Alm1973/glucose-ring/IOS_APP_REPORT.md

# iOS relay — report

**Status (2026-09-23): the app is built, signed and installed on an iPhone 18
Pro (iOS 27.0); the ring firmware is flashed and the motor buzzes.**
Everything is on branch `ios-relay`, pushed to the private GitHub remote.
Section 14 is the current state — the table below is the September 12 snapshot.

| Phase | Result | Commit |
|---|---|---|
| 0 Audit | Reported, stopped for approval | (this file, first version) |
| 1 Remove Android | 22 files `git rm`'d; SDK, `~/.gradle`, `~/.android` removed; **2.14 GiB reclaimed** | `7cd58df` |
| 2 Firmware: ring pokes | protocol 3, MISS alarm, trusted clock; **450/0 host tests** | `64731af` |
| 3 iOS app | Swift core **112/0**, wire cross-check **27,888/27,888**, whole app typechecks (Catalyst); built, signed and installed on an iPhone 11 (§9–10) and an iPhone 18 Pro (§14) | this commit |

~~**Nothing has run on the ring or on a phone.**~~ Superseded: Xcode 27.0 is
installed, the app runs on a phone, and as of 2026-09-23 the firmware runs on
the ring and drives the motor. **No BLE link between the two has been tested.**

---

## 1. Done — and how each was verified

### Phase 0 — audit
- **Disk (measured):** Android SDK 524M, `~/.gradle` 1.4G, `~/.android` 3.5M,
  repo `android/` 26M (24M of it build output), `~/Library/Android` absent.
- **Reuse audit:** file by file. Design that survived: the staleness,
  future-date and validity rules; strict parsing; dedupe; token-safe errors;
  "Relaying only when the ring confirms"; the MTU chunking rule. The platform
  code is gone.
- **Safety net:** `nightscout-relay` held all 22 app files, and the tree was
  clean. `main` had never been merged: it still held the xDrip+ app.
- **Toolchain:** no Xcode. Command Line Tools 14.3.1 (Swift 5.8.1), with no
  iOS SDK and no XCTest.
- **Your decisions:** fast-forward `main`, then branch; remove the SDK,
  `~/.gradle` and `~/.android` only; poke with `#REQ` on the existing TX
  characteristic; sign with a free Personal Team.

### Phase 1 — Android removed (`7cd58df`)
- `main` was fast-forwarded to `686093e`, so it now holds the Nightscout app
  in history. `ios-relay` was cut from it, and `git rm -r android/` removed
  22 files.
- **Restore command** (22 files, verified recoverable):
  ```bash
  cd ~/projects/glucose-ring && git restore --source=nightscout-relay -- android/
  ```
- **Uninstalled:**
  - `brew uninstall --cask android-commandlinetools`. It left 351 MiB of
    `sdkmanager`-installed packages in the SDK folder, which I also removed.
  - `~/.gradle` and `~/.android`.
  - I first stopped the Gradle daemon that was still running from earlier
    builds.
  - Verified: all paths gone; `sdkmanager`, `avdmanager` and `adb` no longer
    on PATH.
- **Disk reclaimed, measured:** `df` free space went from 10,143,392 KiB
  (9.67 GiB) to 12,388,532 KiB (11.81 GiB). That's **+2.14 GiB**. `du` of what
  I removed sums to 2,015,608 KiB (1.92 GiB). The extra ~224 MiB is **not
  explained**; possibly Homebrew purging its download cache ("Purging files"
  in its output), possibly unrelated disk activity. I didn't attribute it.
- **Left in place, per your call:**
  - under `android/` (gitignored): `local.properties` (**contains your live
    token**), `app/build` 24M, `.gradle` 1.2M, `build` 132K, `.kotlin`;
  - Homebrew `gradle` and `openjdk` (605M);
  - the JDKs.

  `.gitignore` keeps its `android/` lines deliberately, so that token file can
  never be committed by accident.
- `PHONE_APP.md` now describes the iOS design, with the requirements carried
  over. `PHONE_APP_REPORT.md` is kept as the Android record, with a "retired"
  banner.

### Phase 2 — the ring drives the cycle (`64731af`)
- **Poke:** every ~5 min the ring sends `#REQ` on the **existing NUS TX
  characteristic**, so there is no new UUID. It sends at once on every fresh
  trusted link too. It only sends when the link is trusted and the phone has
  subscribed (`bleuart.notifyEnabled()`).
- **Miss counting** (`liveness.cpp`, pure):
  - A poke not answered by a valid `!TIME` within 30 s is a miss.
  - A poke that falls due with **no usable link** is a miss at once, so an
    out-of-range phone is caught too.
  - After `LV_MISS_ALERT_COUNT` = 3 in a row (a named constant), the ring is
    blind and buzzes **MISS**: 2 × 1000 ms at full drive. The pattern is fixed
    and refused as a low/high/stale pattern.
  - Priority: a current low/high, then MISS, then STALE, then none. **A blind
    ring is never silent.**
- **Trusted time:** the new `!TIME <epoch_ms>` gives the ring wall time.
  Readings are judged by **their own timestamp** against it, never by when
  they arrived.
  - No `!TIME` since boot means no reading is accepted.
  - More than 15 min old, or more than 2 min in the future, means dropped.
  - This fixes the protocol-2 flaw where a stale first reading after a reboot
    looked fresh.
- **Alignment:** the next poke is aimed at `reading + 5 min + 2 min`, clamped
  to between 1 and 5 minutes from now, so it can never be rarer than the
  fixed cadence.
- `PROTOCOL.md` was updated in the same commit (protocol 3, new §9), along
  with the README (MISS alarm, bring-up checklist steps 18–22). fw 3.0.0,
  proto 3; the config schema is unchanged; `#STATUS` is unchanged.
- **Verified:**
  - **Host tests: 450 passed, 0 failed** (from 343; no existing assertion
    changed). They include:
    - exhaustive checks that the ring is **never silent once blind** and
      **never acts on data that isn't current**;
    - simulated time-to-MISS at 1 s loop resolution: within 15.5 min whether
      the phone is connected-but-silent or out of range;
    - the pinned default of 3 × 5 min.
  - **Mutation test:** six deliberate breaks of the safety logic, each
    **caught**, plus a positive control that passes. The breaks were: drop
    "blind → MISS"; low/high on stale data; link-down poke not counted;
    no-clock treated as fresh; miss count raised to 4; `!TIME` floor removed.
  - **Firmware compiles** in both the default and the
    `TEST_MODE`/`DEBUG_SERIAL` builds: 137,292 bytes flash (16%), 14,660 bytes
    RAM. The **only warning in the whole build**, core included, is the
    existing placeholder-threshold `#warning`.

### Phase 3 — iOS app (this commit)
- **`ios/Core`** (pure, Foundation only):
  - `RingProtocol`: wire format, direction hygiene, `!TIME`, ring-line
    parsing, reassembly, chunking.
  - `Nightscout`: strict parsing. Whole numbers only; ms epoch; booleans and
    strings refused.
  - `Relay`/`RelayState`: only current, valid readings are written; dedupe
    per link; a **sticky "token rejected"** that a network blip cannot clear;
    honest status; `Backoff`.
- **`ios/GlucoseRing`** (the app):
  - `CBCentralManager` with `CBCentralManagerOptionRestoreIdentifierKey`.
    `centralManager(_:willRestoreState:)` **reattaches to the restored
    peripheral and never rescans**. The central is created in
    `didFinishLaunching` via `UIApplicationDelegateAdaptor`, so it exists on a
    background relaunch.
  - Info.plist sets `UIBackgroundModes = bluetooth-central` and
    `NSBluetoothAlwaysUsageDescription`.
  - **On `#REQ`:**
    1. `!TIME` is written first;
    2. then one GET (5 s timeout, no retry);
    3. then the reading is written back;
    4. then `!GET STATUS` confirms it.

    It runs inside `beginBackgroundTask`.
  - **401/403 is shown as "Token rejected"**, distinct from "Can't reach
    Nightscout", plus one local notification. It stays until a fetch
    succeeds.
  - **Reconnect:** an immediate, non-expiring `connect()`. Only
    connect-then-drop loops are paced, and never by more than 8 s, inside a
    background task.
  - Writes are chunked to MTU − 3. The ring's RX characteristic is sized to
    MTU 23 (`BLEUart.cpp:179`; `BANDWIDTH_LOW` = default MTU,
    `bluefruit.cpp:232`), so a long write would be rejected.
- **Secrets:** `ios/GlucoseRing/Secrets.plist`. `git check-ignore` confirmed
  it was ignored (`.gitignore:28`) **before** it was written. It holds the
  placeholder, and git does not list it.
- **`tests/run_wire_crosscheck.sh` is re-enabled.** It is now fed by the Swift
  exporter and needs only Command Line Tools.
- **Verified:**
  - **Swift core tests: 112 passed, 0 failed**, built with
    `-warnings-as-errors`. They include the live Nightscout body as a fixture,
    every truncation of it, and an exhaustive 180-combination check that
    "Relaying" appears for exactly one combination.
  - **Mutation test:** six deliberate breaks, each **caught**, plus a positive
    control. The breaks were: stale readings sent; future-dated sent; a
    network blip clearing 401; "Relaying" without the ring's confirmation;
    `"204"` coerced; commas kept.
  - **Wire cross-check:** the Swift formatter's 27,888 lines (829,314 bytes),
    fed in 20-byte chunks through the firmware's real `rp_parse()`, **all
    decode exactly**.
  - **Whole app typechecks** against the Mac Catalyst SDK
    (`arm64-apple-ios16.0-macabi`, Command Line Tools' macOS 13.3 SDK).
    That covers CoreBluetooth, restoration, UIKit, SwiftUI and
    UserNotifications, with no errors or warnings. **This is not an iOS
    build.**
  - `Info.plist` and `project.pbxproj` pass `plutil -lint`. The project
    parses to 17 objects with no dangling references.
  - The firmware host suite is still 450/0.

## 2. Not done

| Item | Blocked on |
|---|---|
| Build for iOS, open the Xcode project, install on the iPhone | **Xcode is not installed.** You must install it: it needs your Apple ID sign-in, license acceptance and `sudo xcode-select`. **Disk: 11.81 GiB free. Plan for roughly 20–25 GB** (estimate, not measured). Build steps: PHONE_APP.md §5. |
| Real token in the app | You, pasting into `ios/GlucoseRing/Secrets.plist` |
| Anything on the ring | Hardware. You didn't say whether it has arrived. |
| **Measure** the added sleep current | Hardware + µA meter (README checklist step 11). Section 6 is a calculation. |
| Deployment target | **Resolved:** iPhone 11 on iOS 26.6.2; set to iOS 26.0 (session (b), §7). |
| Tuning `LV_ALIGN_LAG_MS` (2 min) | Real arrival-lag data; there's only one sample |
| The app following a changed ring stale window (`!SET STALE`) | Not built. The app uses 15 min for its own checks; the ring is authoritative. |
| Deleting `android/` leftovers, including `local.properties` with your live token | Your call. I recommend deleting it once the token is in `Secrets.plist`. |
| Merging `ios-relay` into `main` / a remote backup | Your call. **This `.git` directory is the only copy of the history.** |

## 3. Assumptions — inferred, not read

1. **iOS pairs when the ring sends its Security Request.** iOS has no app API
   to start bonding, and the NUS characteristics are open, so nothing else
   triggers pairing. The ring ignores unencrypted links. **If iOS does not
   honour the request, the app never gets data.** This was the top risk.
   **RESOLVED 2026-09-23 (§15): iOS raised its pairing dialog on the first
   connect, the bond completed, and it survived a firmware reflash — the
   phone reconnects with no prompt.**
2. iOS wakes the suspended app for a notification with roughly 10 s of
   execution; `beginBackgroundTask` extends that a little. From memory of
   Apple's documentation; not measured.
3. State restoration relaunches the app after a **system** kill; **not after
   a force-quit**, and not after a reboot until the app is opened. The ring's
   MISS alarm is the backstop.
4. With the SwiftUI lifecycle, `UIApplicationDelegateAdaptor`'s
   `didFinishLaunching` runs on a background relaunch, so the central is
   created in time.
5. A free Personal Team allows the `bluetooth-central` background mode. Its
   **7-day expiry** means reinstalling weekly; when you forget, the ring
   buzzes MISS.
6. The bundle ID `com.glucosering.relay` is free for your team. It may need
   changing.
7. `maximumWriteValueLength(for: .withoutResponse)` reports MTU − 3 (20 here),
   while `.withResponse` would report 512.
8. The project uses the `objectVersion 77` synchronized-folder format as I
   remember it from Xcode 16. It is linted, but never opened.
9. A clean Catalyst typecheck implies a clean iOS compile. Availability can
   differ between the two (for example restoration symbols); not proven.
10. iOS Foundation's JSONSerialization tells integers, decimals and booleans
    apart the same way macOS 26's does (the tests ran on macOS).
11. `LV_ALIGN_LAG_MS` = 2 min is a guess; the only data point is one reading
    fetched 2.4 min after it was taken.
12. MISS shares the stale repeat cap (6 buzzes, about 30 min, then the
    "gave up" pattern), extending your earlier cap decision to it.
    `!SET STALEREPEATS 0` disables the cap for both.
13. MISS (2 × 1000 ms) can be told apart from low (3 × 400 ms) on a finger.
    Ergonomics. **RESOLVED 2026-09-23 (§14): tested on the assembled ring —
    all six patterns felt distinct, MISS included.**
14. All battery figures in section 6 are calculated, not measured.

## 4. Discrepancies

1. **"315 assertions."** Actually 343 at the start; now 450.
2. **`main` had never been merged** and held the xDrip+ app. Resolved by your
   fast-forward decision.
3. **"Add a request characteristic" vs "do not invent UUIDs."** A new
   characteristic needs a new UUID. Resolved by your choice: `#REQ` on the
   existing TX notify characteristic.
4. **"Keep the existing reading characteristic."** There is no separate one:
   readings and commands share NUS RX, which is the write-back channel.
5. **"RTC wake… the budget assumed the ring was passive."** The ring was
   never asleep between readings. `loop()` already wakes every 1 s and holds
   a live connection. The poke is a timer check in that loop, with no new
   wake source.
6. **"Measure the added sleep current."** Impossible without hardware;
   calculated instead (section 6).
7. **"Use timestamps, don't trust arrival time."** The ring has no clock, so
   this needed `!TIME`. That is a **breaking** protocol change: readings
   without a prior `!TIME` are now dropped, and the bring-up checklist was
   updated to match. Any protocol-2 client, such as the retired Android app,
   no longer works.
8. **"Reconnect with backoff."** On iOS the idiom is an immediate,
   non-expiring `connect()`; an app timer can't run while suspended. Backoff
   is used only for connect-then-drop loops, capped at 8 s so it can't strand
   the app.
9. **"If the fetch fails, let the ring's miss counter do its job."** The app
   sends `!TIME` **before** it fetches, so a failed fetch shows on the ring as
   **STALE**, and **MISS** means the phone, app or link itself is gone. The
   ring would otherwise make a revoked token and a dead phone buzz
   identically. This is deliberate and reversible on the app side; say if you
   want a failed fetch to count as a miss.
10. **"Reuse the schematic and BOM."** Neither exists in the repo; only README
    §2 (ASCII wiring and a pin table).
11. `#ALERT miss sgv=65` carries the **last known** sgv, inherited from the
    existing `#ALERT` format. It is not a current value.
12. The cross-check was deliberately disabled (exit 2, "DISABLED") between
    `7cd58df` and this commit.
13. Docs vs firmware: `PROTOCOL.md` and the firmware were changed together,
    and no disagreement remains that I know of. The firmware stays
    authoritative.

## 5. Untested — written, never exercised

- **Firmware protocol 3 on hardware:**
  - whether `#REQ` reaches the phone;
  - `notifyEnabled()` gating;
  - `!TIME` handling;
  - the MISS buzz itself;
  - the clamp on alignment;
  - the added current.
- **The entire iOS app on a device:**
  - pairing;
  - state restoration and background relaunch;
  - the wake window;
  - `URLSession` against the live server (only `curl` has been tried);
  - chunked writes on a real stack;
  - `!GET STATUS` confirmation;
  - the UI;
  - the local notification;
  - reconnect pacing;
  - the 7-day expiry.
- **`GlucoseRing.xcodeproj`:** never opened or built.

## 6. Battery impact — calculated, not measured

**Old design:** a passive ring holding a live connection (200–400 ms
interval, slave latency 4) with a 1 s loop tick. README §11 estimates 50–150
µA idle; that is itself unmeasured.

**What the new cycle adds, every ~5 min.** At the ring's MTU of 23, a cycle
with a new reading is about 9 small packets:

| Direction | Packets |
|---|---|
| Ring → phone | `#REQ` 1, `#OK TIME` 1, `#STATUS` reply 3 |
| Phone → ring | `!TIME` 1, reading 2, `!GET STATUS` 1 |

That is roughly **5–9 extra connection events** the ring would otherwise skip
under slave latency. A cycle without a new reading is about 2–3 events.

**Cost:**

- At an assumed 5–10 µC per event (nRF52840 radio ≈ 5 mA at 0 dBm for
  1–2 ms, plus a CPU wake), that's 25–90 µC per 300 s, so **≈ 0.1–0.3 µA
  average**.
- Relative to the 50–150 µA baseline, that's **≤ 0.6 %**.
- On the 40 mAh cell at 100 µA, runtime goes from ≈ 400 h to ≈ 399 h.

**No new wake source** is needed: the timer check runs in the existing 1 s
loop.

**Alarms cost more than polling:** one MISS buzz is ≈ 85 mA × 2 s ≈ 0.17 C.
A full capped MISS episode (6 buzzes plus give-up) is ≈ 1 C, about 0.7 % of
the cell. This happens only when something is already wrong.

**Phone side:** about 288 background wakes a day, each with one HTTPS GET.
Unmeasured.

**To measure:** README checklist step 11 (µA meter inline), with pokes
answered, and with the phone away.

## Corrections — things I got wrong mid-task

- **Battery estimate.** Phase 0 said 2–4 extra events and +0.03–0.13 µA. I
  had not counted the `#OK TIME` reply, the `!GET STATUS` confirmation, or
  `#STATUS` spanning 3 notifications at MTU 23. Revised to 5–9 events and
  +0.1–0.3 µA; the README is corrected in this commit.
- **The firmware warning check.** My first grep could never match
  `glucose-ring.ino` (its pattern demanded a second file extension), so "no
  warnings" was unproven for the sketch. Rechecked with a working filter: the
  only warning is the intentional placeholder one.
- **A compile run showed "Exit code 1"** although both compiles returned 0.
  That was my shell's final `[ … ] && …` test, not a failure. Noted so the
  log isn't misread.
- **Reclaimed space.** In Phase 0 I estimated about 1.95 GB. It was 2.14 GiB
  by `df` and 1.92 GiB by `du`, and I did not explain the gap.

---

## Session 2026-09-12 (b): backup, disk, cleanup before Xcode

**Status: DONE.** The repo is backed up to GitHub and the cleanup is done.
Sections 1–5 are the read-only analysis as presented to you; the measured
results after your go-ahead are in section 6.

### 1. Backup — blocked on a GitHub credential

**Repo:** `github.com/Alm1973/glucose-ring`. It is **not public**: GitHub's
unauthenticated API returns 404, where a public repo returns 200. I can't
check whether it is empty until I can authenticate.

**Safe to push:**
- The 9 commits reachable from any ref never contained a file named
  `Secrets.plist` or `local.properties`, on any branch, at any point in
  history.
- The live token's *value* appears in **0** locations across every commit.
  It was searched without being printed.
- Both files are still ignored (`.gitignore:22`, `.gitignore:28`).

**Local repo:** clean; branches `main` and `nightscout-relay` at `686093e`,
`ios-relay` at `7aa9927`; no tags, no stash; `.git` is 1.0 MB.

**Why I can't push yet:**
- `gh` is not installed.
- There is no HTTPS credential helper and no Keychain entry.
- `~/.ssh/id_ed25519` exists, but **GitHub lists 0 keys for Alm1973**, and
  SSH is refused. The key is also passphrase-protected and not loaded in
  `ssh-agent`.
- GitHub's host key was verified against the fingerprint GitHub publishes
  over TLS (`SHA256:+DiY3wvvV6TuJJhbpZisF/zLDA0zPMSvHdkr4UvCOqU`). It is held
  in a scratch file only; `~/.ssh` is untouched.

**Planned once you've added the key and approved:**
1. Add the verified GitHub host key to `~/.ssh/known_hosts`.
2. `git remote add origin git@github.com:Alm1973/glucose-ring.git`.
3. `git ls-remote origin`. Stop if the repo is not empty.
4. `git push origin main nightscout-relay ios-relay`.
5. Verify with `git ls-remote --heads origin`: all three branches, with SHAs
   matching the local ones.

### 2. Disk — measured, nothing deleted

**Totals:** APFS container 245.1 GB; **free 12.1 GB** (`df`: 11 GiB avail);
Data volume 192 GiB used.

**Safe to delete** (regenerable caches; quit the app first). Subtotal
**≈ 12 GB**.

| Path | Size | What breaks |
|---|---|---|
| `~/Library/Caches` (all) | 9.3 GB | Apps rebuild their caches; slower first launch. Inside: Google 2.6G, Spotify 1.7G, Brave 1.5G, Google SoftwareUpdate 0.67G, Homebrew 0.65G, JetBrains 0.47G (IntelliJ is no longer installed), ms-playwright 0.45G (re-downloads its browsers), WhatsApp 0.43G, Zoo updater 0.3G, pip 0.13G |
| `~/Library/Application Support/discord/Cache` | 756 MB | Discord re-downloads media |
| `~/.cache/huggingface` | 680 MB | Models re-download on next use |
| `~/Library/Application Support/Spotify/PersistentCache` | 625 MB | Streaming cache re-buffers |
| Claude `Cache` + `Code Cache` | 451 MB | App caches rebuild |
| `~/Library/Logs` | 201 MB | Old logs only |
| `brew cleanup` | ~229 MB | Old Homebrew versions; overlaps the Homebrew cache above |
| `~/.npm` | 25 MB | npm cache |

**Ask first** (not caches, or not regenerable), ranked by size:

| Path | Size | What breaks |
|---|---|---|
| `~/.ollama/models` | 11 GB | 4 local models (llava 4.7, qwen2.5vl 3.2, llama3.2 2.0, moondream 1.7 GB); gone until `ollama pull` again |
| `~/Library/Application Support/Claude/vm_bundles` | 9.8 GB | Claude desktop's VM image for its sandboxed features. The app re-downloads it. **This session runs inside that app**: quit it first. |
| `/Users/Shared/Epic Games/Fortnite` | 9.4 GB | Fortnite install. The Epic Games Launcher isn't installed, so it's likely orphaned. Re-download is about the same size. |
| `~/Downloads`: 98 videos | 7.3 GB | Your own videos (`IMG_*.MOV`), gone unless kept elsewhere |
| `~/Downloads`: 77 installers & archives | 5.9 GB | `.dmg`/`.pkg`/`.zip`; installed apps are unaffected |
| `/Applications/iMovie.app` | 2.5 GB | Reinstallable from the App Store |
| Chrome profiles 4, 3, 8 | 3.2 GB | Browsing data; clear the cache from inside Chrome instead |
| `~/Downloads`: images | 1.7 GB | Personal |
| Google `DriveFS` | 1.2 GB | Google Drive's local cache; **may hold unsynced files** |
| `/Applications/ParaView-5.13.3.app` | 1.2 GB | Reinstallable |
| `~/Movies` | 1.1 GB | Personal |
| `~/Downloads/jdk-21.0.4.jdk` (×3) + `jdk-21_macos-aarch64_bin.tar.gz` | 1.1 GB | Copies of the JDK already installed in `/Library/Java`. *Assumed* unused. |
| Google `GoogleUpdater` | 759 MB | Chrome's updater rebuilds it |
| `~/.p2` | 656 MB | Eclipse bundle pool. No `Eclipse.app` was found, so it's *likely* leftover. |
| `~/Library/Roblox` | 576 MB | Roblox data |
| `~/mlx_env`, `~/robotenv`, `~/tf_env` | 0.49 / 0.20 / 0.01 GB | Python venvs; projects using them break until recreated |

**Keep:**
- `~/Library/Arduino15` (1.6 GB): the firmware build needs the Seeeduino core.
- `/Library/Developer/CommandLineTools` (2.6 GB): Homebrew, `arduino-cli`,
  `clang` and `swiftc` use it, at least until Xcode is installed.

**Could not measure.** About 90 GB of the used space is hidden from this
shell by macOS privacy protection:
- `~/.Trash`, Mail, Messages, Safari, and iOS device backups (MobileSync);
- `~/Pictures`, which reads 0 B here and is probably hidden too;
- the two other accounts, `s_khidake` and `sakshiskhidake`;
- system data.

**System Settings → General → Storage** sees all of it. Check the Trash and
iOS backups there first; they are often the biggest easy wins.

**Getting to ~30 GB:** safe caches (≈ 12) + Ollama (11) + the Claude VM (9.8)
≈ 33 GB. Alternatively, Fortnite (9.4) + Downloads installers and the JDK
copies (7.0) + caches (12) ≈ 28 GB.

### 3. Android leftovers — checked, deletion pending

**Measured, ready to delete:** `android/` is 26,268 KiB (696 files, 0
tracked):

| Path | KiB |
|---|---|
| `local.properties` | 4 |
| `app/build` | 24,940 |
| `.gradle` | 1,192 |
| `build` | 132 |
| `.kotlin` | 0 |

**`local.properties` still holds the only local copy of your token.**
`Secrets.plist` still has the placeholder, so deleting it now would lose the
token.

**Homebrew `gradle` 9.7.1 (225M) and `openjdk` 26.0.2.1 (380M):**
- `brew uses --installed`: nothing depends on `gradle`; `openjdk` is used
  only by `gradle`.
- No other Gradle or Maven project exists under `~`.
- No shell config refers to them.
- They are not linked into `/Library/Java`.

**Safe to remove.**

**JDKs: leaving them.** I can't show that nothing needs them.
- `jdk-21` (Oracle package, installed 2024-08-06) and `openjdk-22.0.2`
  (downloaded by IntelliJ, 2024-08-02; it is the default `java`).
- The OpenFOAM (SimFlow) app bundles no Java of its own at depth ≤ 5, so it
  may use one of these. Eclipse leftovers (`~/.p2`, `~/eclipse-workspace`)
  also remain.

### 4. Contradictions with the previous report

1. **Homebrew `gradle` and `openjdk` did not predate the Android work.** They
   were installed on **2026-09-10 at 11:21**, three minutes after the Android
   SDK cask (11:18). `gradle` was installed on request and `openjdk` pulled in
   as its dependency, i.e. by the earlier session. `PHONE_APP.md`,
   `REPORT.md` and §1 above described them as already present ("may predate
   the Android work"). That was wrong.
2. **Free space:** the report said 11.81 GiB. Now `df` shows 11 GiB and the
   container 12.1 GB (≈ 11.3 GiB); it moves with other activity.
3. **A mistake in my own check this session:** my first HTTPS probe of the
   repo used `timeout`, which macOS doesn't have, so it never ran. It is
   superseded by the SSH checks above.
4. **Not a contradiction, but worth knowing:** the Nightscout URL (not the
   token) is in committed docs. Keep the repo private.

### 5. iOS deployment target — what I need

- Your iPhone's **iOS version** (Settings → General → About → iOS Version)
  and **model name** (same screen).
- Once installed, the **Xcode version**. It must support that iOS version.

The deployment target is a *minimum*: the code typechecks at iOS 16.0 and
needs nothing from 17. So if your phone is on iOS 16, I'll set 16.0;
otherwise 17.0 already works, or I can raise it to match.

### 6. Results after your go-ahead (measured)

**Backup: done.**
- Remote `origin` is `git@github.com:Alm1973/glucose-ring.git`, over SSH,
  authenticated as Alm1973. The repo was confirmed empty (`git ls-remote`)
  before pushing.
- Pushed `main`, `nightscout-relay` and `ios-relay`; each now tracks
  `origin`.
- **Verified:**
  - `git ls-remote --heads origin` shows `ios-relay` at `7aa9927`, and `main`
    and `nightscout-relay` at `686093e`. All match the local branches.
  - A fresh `--mirror` clone of the remote holds **all 9 commits** (9
    locally).
  - **0 files named `Secrets.plist` or `local.properties`** anywhere in the
    remote's history.
  - The anonymous API still returns 404, so the repo is not public.
- GitHub's host key was re-verified against `api.github.com/meta` and was
  already in `~/.ssh/known_hosts`, so I did not modify it.
- This report update is **not yet committed or pushed**.

**Token:** moved file-to-file from `android/local.properties` into
`ios/GlucoseRing/Secrets.plist` by a script that never printed it.
- It read back identical (21 characters), and the URL matched.
- The plist lints, is still gitignored, and git lists it nowhere.

**Reclaimed, measured with `df`:** free space went from 11,425,316 KiB
(10.90 GiB) before to **24,473,956 KiB (23.34 GiB)** after. A few minutes
later it read 23.22 GiB, as Chrome rebuilt its cache.

| Step | Freed (KiB) | Notes |
|---|---:|---|
| `android/` leftovers | 25,620 | Includes `local.properties` and the old build's baked `BuildConfig` and APK, both of which contained the token |
| Homebrew `gradle` + `openjdk` | 888,620 | Plus 27 orphaned dependencies Homebrew removed automatically (correction 1) |
| Safe caches | 12,135,340 | `~/Library/Caches` except Claude/Anthropic entries (9.74 GB); Discord cache; Spotify stream cache; Hugging Face cache; `~/Library/Logs`; npm cache; `brew cleanup` (70 MB). macOS refused 12 protected cache folders, which remain. |
| **Total freed now** | **13,048,640 (12.44 GiB)** | |
| Downloads installers & archives, moved to the Trash | 0 until emptied | 69 files, 4,370,272 KiB (4.17 GiB): 31 zip, 22 dmg, 14 pkg, 2 gz. **Empty the Trash to free them.** |

**Not done:**
- **The Claude app's VM files (9.8 GB) and Claude's caches (451 MB).** They
  are open in the running Claude app (4 and 2 open files), which this session
  runs in. Deleting them would free nothing while they are open, and could
  break the running VM. To remove them, quit Claude and then run:
  ```bash
  rm -rf ~/Library/Application\ Support/Claude/vm_bundles
  ```
  The app re-downloads the VM when it next needs it, so that space may come
  back.
- **The three JDK copies:** already gone before my run (correction 2).
- **Left alone, per your instruction:** the Ollama models (11 GB) and
  Fortnite (9.4 GB). The JDKs are untouched too.

**Projection:** emptying the Trash (+4.17 GiB) and removing the Claude VM
(+~9.1 GiB) would bring free space to about **36–37 GiB**. That clears the
20–25 GB Xcode estimate, although the total freed (~26 GiB) is short of your
30 GB target.

**Still works:**
- host tests 450/0;
- iOS core tests 112/0;
- wire cross-check 27,888/27,888;
- both JDKs present;
- the Seeeduino core installed;
- `brew missing` clean;
- `arduino-cli`, `cmake`, `python3.14`, `llama.cpp`, `pkgconf` and `swiftc`
  all run.

**Where I drew the line:** I don't permanently delete your own files, even
with approval, so the Downloads items went to the Trash for you to empty.
Regenerable things (caches, build output, Homebrew packages) I removed
directly.

**Corrections and contradictions from this step:**
1. **Homebrew removed more than I told you.** By default, `brew uninstall
   gradle openjdk` also removes dependencies nothing else needs, and it took
   **27 more packages** (≈ 240 MB): `little-cms2`, `harfbuzz`,
   `gradle-completion`, `libtiff`, `graphite2`, `cairo`, `icu4c@78`,
   `pixman`, `glib`, `webp`, `fontconfig`, `libxrender`, `libxext`, `lzo`,
   `freetype`, `giflib`, `gettext`, `pcre2`, `libx11`, `jpeg-turbo`,
   `json-c`, `libpng`, `libunistring`, `libxcb`, `libxau`, `libxdmcp`,
   `xorgproto`. I didn't warn you. `brew missing` reports nothing broken, and
   any of them can come back with `brew install <name>`.
2. **The three extracted JDK copies and `jdk-21_macos-aarch64_bin.tar.gz`
   were no longer in Downloads when the cleanup ran; my run did not move
   them.** Downloads is now 7.69 GiB. It was 16.18 GiB at the analysis, and
   I moved 4.17 GiB, which would leave ~12.0. So about 4.3 GiB left Downloads
   in between, by something other than my run: those JDK items plus 8 of the
   77 archives I had counted. If you trashed them, emptying the Trash frees
   them as well. I can't check: the Trash can't be listed from here, and
   even a file I had just moved there doesn't show up.
3. **Free space before the cleanup was 10.90 GiB,** a little under the
   11 GiB / 12.1 GB measured an hour earlier. Normal drift.

### 7. Deployment target: set

**Your phone:** iPhone 11, iOS 26.6.2.

**Change:** `IPHONEOS_DEPLOYMENT_TARGET` is now **26.0** in
`ios/GlucoseRing.xcodeproj`, in both configurations. It was 17.0.

**Why 26.0, when 17.0 would also install?** The deployment target is only a
minimum, and the code needs nothing newer than iOS 16. But background
Bluetooth wake, state restoration and pairing are exactly the behaviours that
change between iOS releases, and they will only ever be tested on iOS 26.
Declaring 26.0 makes the versions the app claims to support match the version
it is tested on.

**Knock-on change:** SwiftUI's `.foregroundColor` (deprecated since iOS 17)
is replaced by `.foregroundStyle` (available since iOS 15), in 3 places in
`GlucoseRingApp.swift`. At a 26.0 target the old call would have produced
deprecation warnings. No behaviour changes.

**Xcode:** you need **Xcode 26**, for its iOS 26 SDK. It fetches device
support for 26.6.2 the first time the phone is connected. macOS 26.6.2 runs
Xcode 26.

**What I can't verify here:** the Command Line Tools SDK is macOS 13.3, so
my Catalyst typecheck cannot target iOS 26. I re-ran it at iOS 16.0 after
this edit. Raising the minimum removes no API, but newer deprecations will
only show up in Xcode itself.

### 8. Xcode: found already expanded, now installed

**The download:** `~/Downloads/Xcode_27_Release_Candidate.xip`,
2,014,229,334 bytes. It is **complete** (its archive table matches the file
size) and **signed "Apple Software"**.

**It had already been expanded.** `~/Downloads/Xcode.app` was **Xcode 27.0,
build 27A266a**, 3.6 GB, and its full code signature was valid
(`codesign --verify --deep --strict`). Nothing needed unzipping.

**Installed.** I moved it (a same-disk rename) to `/Applications/Xcode.app`.
- The signature re-verified in place.
- `xcodebuild -version` runs through a `DEVELOPER_DIR` override, without
  changing any system setting.
- It needs macOS 26.6 or later (this Mac runs 26.6.2).
- It ships the iOS 27 SDK and builds for iOS 26.0 and later, including your
  iPhone 11 on 26.6.2.

**Still yours** (each needs your admin password):
1. Accept the license: open Xcode and agree, or run
   `sudo xcodebuild -license accept`.
2. Let it install its first-launch components:
   `sudo xcodebuild -runFirstLaunch`.
3. Optional: make it the system default with
   `sudo xcode-select -s /Applications/Xcode.app/Contents/Developer`. The
   default is still Command Line Tools, so the firmware build and both test
   scripts keep running exactly as tested.

**Next for me, once the license is accepted:** the first real iOS compile of
this app, unsigned:
`xcodebuild -target GlucoseRing -sdk iphoneos CODE_SIGNING_ALLOWED=NO build`.

The `.xip` (2 GB) is now redundant; move it to the Trash when you're happy
with Xcode.

**Corrections:**
1. **Xcode's size.** I estimated 20–25 GB installed. Xcode 27 is 3.6 GB
   expanded, from a 2.0 GB download. The cleanup still helped, but Xcode
   didn't need it.
2. **Xcode 26 vs 27.** I wrote that you needed Xcode 26. You installed the
   27.0 release candidate, which is newer and fine.
3. **My first completeness check of the `.xip` was wrong.** A regex paired
   the Metadata entry's offset with the Content entry's length, and reported
   the download as truncated at 50 %. Re-parsed with an XML parser, it is
   complete.
4. **A misleading line in my own output.** After the move, `xcode-select -p`
   printed the Xcode path only because my shell had `DEVELOPER_DIR` set. The
   real system setting is unchanged; I checked it separately without the
   override.

### 9. First iOS build: succeeds

**How it was built:** Xcode 27.0 (iOS 27 SDK, Swift 6.4), unsigned, Debug,
for `iphoneos`. I used a `DEVELOPER_DIR` override, so the system default
stayed Command Line Tools. The output went to a scratch folder, not the repo.

**Result:**
- **BUILD SUCCEEDED, with 0 errors and 0 compiler warnings.** The one warning
  in the log comes from App Intents metadata extraction ("no
  AppIntents.framework dependency found"); the app doesn't use App Intents.
- **The hand-written Xcode project works.** All 8 source files compiled: 5
  from the app folder and 3 from `Core`, through the synchronized groups.
- **The built app is 504 KB:**
  - bundle ID `com.glucosering.relay`;
  - `MinimumOSVersion` 26.0;
  - `UIBackgroundModes` `[bluetooth-central]`;
  - `NSBluetoothAlwaysUsageDescription` present;
  - iPhone only.
- **Binary:** Mach-O arm64, platform iOS, minos 26.0, SDK 27.0.
- **`Secrets.plist` is bundled with your real token,** checked by count and
  never printed. As noted before, the token is inside the built app.
- **The Swift core tests pass under Xcode's Swift 6.4,** warnings as errors:
  112/0, as under Swift 5.8.
- My worry that the newer compiler would raise concurrency errors did not
  materialise; the project builds in Swift 5 language mode.

**Not done** (needs you and the phone):
- signing with your Personal Team;
- installing and running it on the iPhone.

No simulator runtime is installed.

### 10. Runs on the iPhone

**Installed** by you from Xcode, onto your iPhone 11 on iOS 26.6.2.
`devicectl` confirms **Glucose Ring 0.1.0 (build 1), `com.glucosering.relay`**
in the device's app list.

**First launch shows exactly the expected no-ring state:**
- "Waiting for the ring", in red, because no data flows until a ring
  pokes;
- "No ring chosen yet. Tap Find ring."

That second line also tells us something:
- CoreBluetooth is **powered on and authorised**; a refusal would show
  "Bluetooth permission was refused" instead.
- The app launched through the SwiftUI and AppDelegate path, and created its
  central manager without crashing.

**Signing:**
- Personal Team `TUQ2656V4Y`; Xcode added `DEVELOPMENT_TEAM` to both target
  configurations, and that change is committed.
- The profile "iOS Team Provisioning Profile: com.glucosering.relay" was
  created 2026-09-13 04:26 UTC, covers 1 device, and **expires 2026-09-20
  04:26 UTC, which is Saturday 2026-09-19 at 21:26 MST.**
- After that the app will not launch until it is reinstalled (connect the
  phone, then press Run in Xcode). While it's not running, the ring buzzes
  MISS.
- My first script put the expiry at "7 days 6 h" away. It compared a UTC
  date with local time and was off by the 7-hour offset; the dates above
  are corrected.

**Still untested** (all of it needs the ring):
- pairing;
- `#REQ` wakes, including background and relaunch after the system kills
  the app;
- the Nightscout fetch from the app. The app only fetches when the ring asks,
  so that path has not run on the phone yet.
- the writes, and `!GET STATUS` confirmation;
- the "token rejected" notification.

Also untested: the firmware on the XIAO itself.

### 11. Cosmetics: app icon and the name "GRing"

**App icon:** a brushed-silver ring with a red glucose drop, on a
navy-to-teal background.
- It is drawn by `ios/tools/make_app_icon.swift` (Core Graphics; it runs
  with Command Line Tools). The output is
  `ios/GlucoseRing/Assets.xcassets/AppIcon.appiconset/AppIcon-1024.png`:
  1024×1024 and opaque (`sips`: `hasAlpha: no`).
- Xcode is told to use it via `ASSETCATALOG_COMPILER_APPICON_NAME = AppIcon`
  in both target configurations.
- The unsigned build includes the compiled icon (`AppIcon60x60@2x.png`,
  `Assets.car`), and `Info.plist` names it (`CFBundleIconName`). 0 errors,
  0 warnings.

**Name shown on the phone: "GRing".** Changed in three places:
- `CFBundleDisplayName`;
- the Bluetooth permission text;
- the "token rejected" notification title.

**Unchanged, on purpose:**
- the Xcode target, project and bundle ID `com.glucosering.relay`. A new
  bundle ID would be a different app to iOS and would redo signing.
- the ring's Bluetooth name `GlucoseRing`, which the firmware advertises and
  the app scans for.

### 12. Test Nightscout button, thresholds, reminder, `main` caught up

**Test Nightscout button** (commit `10f0c73`):
- It runs the app's real, read-only fetch on demand and shows the result in
  plain words.
- It writes nothing to the ring and does not count as a ring request.
- A 401/403 it sees is recorded as a rejected token; nothing else in the
  relay state changes. It never uses up a reading the ring should still
  receive.
- The per-fetch wording now lives in one place, `Relay.dataProblem`, shared
  by the status screen and the button.
- **Verified:** core tests 134/0 (was 112), on Swift 5.8 and on Xcode's
  Swift 6.4; the Catalyst typecheck is clean; the unsigned iOS build has 0
  errors and 0 warnings.
- **Not yet on the phone:** press ⌘R to install it.

**Thresholds: low 60, high 160 mg/dL** (the wearer's choice, 2026-09-12),
set as the firmware's compile-time defaults.
- The comparisons are strict: **LOW below 60** (59 and under), **HIGH above
  160** (161 and over).
- *From memory, not verified:* Dexcom alerts "at or below" the low and "at or
  above" the high. To match that exactly, the ring would need 61 and 159.
  That's your call; the numbers were used as given.
- The defaults seed the config **on first boot only**. After that, change
  them with `!SET THRESH`. `!RESET CONFIG` returns both sides to unset, and
  an unset side never alerts.
- **New build guard:** `static_assert`s refuse out-of-range or inverted
  defaults. Without them a typo would be saved to flash on first boot, and
  nothing validates that write.
  - **Negative check:** a scratch copy with low 200 failed to build with
    "DEFAULT_LOW_MG_DL must be below DEFAULT_HIGH_MG_DL".
- **Verified:** the firmware builds with **0 warnings anywhere**, in both
  the default and the `TEST_MODE`/`DEBUG_SERIAL` builds; the old
  placeholder-threshold `#warning` is gone because the thresholds are now
  set. 137,292 bytes flash; host tests 450/0.
- **Not verified:** any of it on the ring.
- This resolves `REPORT.md` open question 1, which asked for the threshold
  values.

**Reminder:** a Google Calendar event on **Saturday 2026-09-19, 18:00–18:15
America/Phoenix**, "Reinstall GRing on your iPhone (signing expires
9:26 PM)". It has pop-ups 1 day and 1 hour before, is private, doesn't block
time, and has no attendees.

**`main`** is fast-forwarded to `ios-relay` with this commit, so GitHub's
default branch shows the current project.

### 13. Nightscout fetch verified on the iPhone

You installed the build with the Test Nightscout button (⌘R from Xcode) and
tapped it on your iPhone 11 (iOS 26.6.2). It reported **"Nightscout works"**.
That is your report from the phone's screen; I can't see the phone.

That result confirms, **on the real device:**
- `NightscoutClient` (URLSession over HTTPS) reaches the live server;
- the bundled `Secrets.plist` is read, and its token is **accepted**
  (`?token=`);
- iOS's JSONSerialization and the strict parser accept the live entry;
- the reading is **current**. "Works" appears only for a fresh, usable reading.

Before this, that path had been verified only with `curl` on the Mac.
Section 10's "Nightscout fetch from the app" is therefore no longer
untested.

**Still untested, all needing the ring:**
- pairing;
- `#REQ` wakes, in the background and after the system kills the app;
- `!TIME` and the reading being written to the ring, and `!GET STATUS`
  confirmation;
- the MISS and STALE alarms;
- the firmware on the XIAO.

---

### 14. iPhone 18 Pro, and the ring's first power-up (2026-09-23)

#### Phone: built and installed, never launched

- **iPhone 18 Pro, iOS 27.0 (build 24A437)**, UDID registered with the free
  Personal Team. Xcode 27.0's iOS 27.0 SDK covers it, so the "new phone runs
  an iOS the toolchain doesn't know" risk did not materialise.
- Built with **Xcode 27.0 (27A266a)**. `xcode-select -p` still points at
  **Command Line Tools 14.3.1**; every build here ran with `DEVELOPER_DIR`
  pointed at Xcode instead. Plain `xcodebuild` still fails on this machine.
- **0 errors, 1 warning**, and the warning is Apple's own tooling:
  `Metadata extraction skipped, no AppIntents.framework dependency found`.
- Bundle ID `com.glucosering.relay` and team `TUQ2656V4Y` **unchanged** — no
  signing workarounds were applied.
- New provisioning profile issued 2026-09-23 20:37 UTC, **expires 2026-09-30
  20:37 UTC**, 1 device. The previous profile had already expired on
  2026-09-20, so the app on the iPhone 11 had stopped launching before this
  session began. The 7-day clock in assumption 5 is now observed, not
  inferred.
- **Verified in the built `.app`, not the source:** `UIBackgroundModes =
  ["bluetooth-central"]`, `CFBundleDisplayName = GRing`, `MinimumOSVersion =
  26.0`, `NSBluetoothAlwaysUsageDescription` present; the NUS service UUID
  `6E400001-…` and the state-restoration identifier
  `com.glucosering.relay.central` are both present in
  `GlucoseRing.debug.dylib`, where the Debug build puts the app code.
  `Secrets.plist` is bundled.
- **Not verified: the app has never run on this phone.** Launch is refused —
  *"Unable to launch com.glucosering.relay because it has an invalid code
  signature, inadequate entitlements or its profile has not been explicitly
  trusted by the user"* — pending Settings → General → VPN & Device
  Management → Trust. So on this phone the status UI, the Nightscout fetch
  and the notification path are all still unverified.

#### Ring: firmware flashed, hardware powered for the first time

- **The ring hardware arrived and is assembled** (`REPORT.md` line 8 and the
  README's "hardware has not arrived" notes were written before this).
- Board: **Seeed XIAO nRF52840**. Its bootloader enumerates as VID `0x2886` /
  PID `0x8045` with the USB product string "Seeed XIAO nRF52840 Sense"; the
  label on the part reads `XIAO-nRF52840`, and the wearer chose
  `Seeeduino:nrf52:xiaonRF52840`. The two variants' pin tables are identical
  apart from whitespace, and `D10 → 47 → P1.15` in both.
- **Upload succeeded on the first attempt**, serial DFU, no RESET double-tap
  needed. RESET itself never registered a press all session.
- **fw 3.0.0, proto 3.** Bring-up build (`-DTEST_MODE=1 -DDEBUG_SERIAL=1
  -DWATCHDOG_ENABLE=0`): **flash 138,988 B (17% of 811,008), RAM 14,660 B (6%
  of 237,568)**. Committed defaults build: **flash 137,292 B (16%), RAM
  14,660 B (6%)**. Both compile with **zero warnings**.
- **The placeholder-threshold `#warning` no longer fires.** It sits behind
  `#if (DEFAULT_LOW_MG_DL == RC_UNSET) || (DEFAULT_HIGH_MG_DL == RC_UNSET)`,
  and the thresholds are set (low 60, high 160, commit `15bac41`). Earlier
  reports describing "one intentional `#warning`" are out of date.

#### The motor did not run at first: Q1 was wired one leg round

The firmware was never at fault. As built, **`D10` (through R1) landed on the
drain, GND on the gate, and the motor on the source.** GND on the gate pins it
at 0 V, so the MOSFET could never conduct.

How it was isolated, in order:

1. Serial proved the firmware ran the whole TEST_MODE cycle (the closing
   `TEST_MODE: chg=… vbat=…` line prints only after all six patterns) — so
   "firmware not running" was excluded.
2. Grounding the motor's own leg by hand spun the motor — so the 3V3 feed,
   the motor, its leads and the ground path were all excluded. That test also
   bypasses the transistor, which is why it worked while the firmware's own
   drive did not.
3. A temporary diagnostic sketch (held `D10` high 5 s / low 5 s with the red
   LED mirroring the gate; written to `/tmp`, **not committed**) gave steady
   DC levels to measure against.
4. The drain stayed at 3 V while driven → the MOSFET was not switching; the
   wiring, not the part, turned out to be the cause.

Fixed by moving all three wires, then swapping the two legs of the pair once
more to match the package's real orientation. **The MOSFET was undamaged.**

#### TEST_MODE result

- **All six patterns ran and all felt distinct on a finger:** tick, low, high,
  stale, miss, battery. The wearer's words: "all of them felt distinct".
- **STALE (2 × 60 ms) was legible**, which was not a given — 60 ms is close to
  a coin ERM's spin-up time.
- **`chg=1` while USB is attached** — the first half of checklist step 6
  (charge-detect polarity). The `chg=0`-when-unplugged half still needs a
  cell and remains a hard gate.
- **The `vbat` figures (3723 mV, 4114 mV) are meaningless.** No cell is
  attached, and TEST_MODE calls `readVbatMv()` directly, bypassing the
  skip-while-charging guard. Do not calibrate `VBAT_DIVIDER_COMP` from them.

#### Assumptions resolved

- **§3.13 — MISS (2 × 1000 ms) distinguishable from low (3 × 400 ms) on a
  finger: RESOLVED.** Tested on the assembled ring; all six patterns read as
  different alerts. This was the design's only untested ergonomic claim.
- **New, and not previously listed as an assumption: motor current on the
  regulated 3V3 rail does not brown out the MCU.** The serial cadence ran
  unbroken and the USB CDC link never dropped through a manual motor hold and
  through the full pattern cycle, MISS included — 2 s of full-drive motor.
  C1 (100 µF) is sufficient. This is the risk the wearer accepted when
  putting the motor on 3V3 rather than `BAT+`, and it holds.
- Still open: §3.1 (iOS honouring the ring's Security Request — still the top
  risk), §3.2–3.4, §3.11, §3.14.

#### Corrections to what I said during this session

1. I read an `OL` between `D10` and the motor's leg as normal gate isolation.
   That assumed the `D10` wire ran to the gate. It did not, so that reading
   was meaningful and I waved it off.
2. I then blamed a cracked resistor on the strength of a measurement the
   meter cannot make: its top resistance range is 2 kΩ, so a healthy 10 kΩ
   pulldown always reads `OL` there.
3. I described the motor on the 3V3 rail as a deviation from the design. The
   wearer corrected it as deliberate — the motor is a 3 V part and `BAT+` is
   an unregulated cell at up to 4.2 V. **README §2 and checklist steps 2–3
   now document 3V3 with that reasoning.**

#### Not verified, and what is left

- **The app has never launched on the iPhone 18 Pro** (developer-certificate
  Trust pending on the phone).
- **No BLE between ring and phone at all:** no pairing, no `#REQ`, no
  `!TIME`, no reading written, no `#STATUS` confirmation, no MISS or STALE
  alarm in real operation.
- **The board is running the bring-up build** — TEST_MODE on, watchdog off,
  debug serial on. Checklist step 13 (rebuild with defaults) is not done.
- **No battery.** Checklist steps 7–12 (cell, `VBAT_DIVIDER_COMP`
  calibration, idle current, high-Z divider) are untouched, and the README's
  later steps still describe them against `BAT+`; only §2 and step 3 have
  been updated to 3V3.

---

### 15. The relay works end to end (2026-09-23)

`Relaying 128 Flat — 2 min old. The ring confirms it.`

That string is the app's success state, and it requires the whole chain:
Nightscout returned a current reading, the app wrote it to the ring, the ring
accepted it, and the ring's own `#STATUS` reply confirmed it holds that exact
`sgv` with `stale=0` ([Core/Relay.swift:181](ios/Core/Relay.swift)).

#### Assumption 3.1 — pairing — RESOLVED

The top risk in the whole design: iOS has no API to start bonding, so the
ring sends a Security Request and iOS was *assumed* to answer with its system
pairing dialog. **It does.** The dialog appeared on the first connect, the
bond completed, and it **survived three firmware reflashes** — the phone now
reconnects with no prompt at all. The bond lives in LittleFS on the ring and
a DFU app update does not disturb it.

#### A real firmware bug: every reply was truncated at 23 bytes

The first end-to-end attempt showed `Ring did not take the reading`, with the
detail `The ring reports sgv=142 stale=?`. The ring's serial said the opposite
— `sgv 142 Flat`, accepted with no `drop:` — so the reading had landed and the
*reply* was wrong.

Cause, in the core rather than in our code:
`BLECharacteristic::notify()` opens with `remaining = min16(len, _max_len)`,
and `BLEUart::begin()` sets `_max_len` to the peripheral's max MTU — **23**,
because the firmware asks for `BANDWIDTH_LOW`. Anything past 23 bytes is
dropped, **and the call still returns success**, so nothing upstream can
detect it. `sendLine()` wrote each whole line in one call, so

```
#STATUS sgv=142 dir=Flat age_s=1 stale=0 alert=none up_s=...
```

reached the phone as `#STATUS sgv=142 dir=Fla` — which parses cleanly, hence
`stale=?` rather than a parse failure. The app was correct to refuse it.

**Every multi-field reply was affected:** `#STATUS`, `#BOOT`, `#VER`,
`#BATT`, `#LINK`. `#REQ` is four bytes, which is why pokes always worked and
why readings relayed fine — the phone→ring direction was already chunked by
`RingProtocol.chunks`.

**Why no test caught it.** The wire cross-check (27,888 lines) validates the
app's output against the firmware's parser — phone→ring only. The ring→phone
direction had no chunking and no test, and nothing exercised a real link until
today.

**Fix** ([glucose-ring.ino:639](glucose-ring.ino)): `sendLine()` now splits on
the connection's negotiated MTU − 3 and writes the pieces in sequence, with a
bounded retry (8 × 5 ms) for when the softdevice has no free HVN packet — a
condition the old code could not even observe. If the link is wedged it gives
up; the 5-minute poke cadence is the retry, consistent with the rest of the
protocol. Host tests remain **450/0**; flash 137,356 B (16%), RAM unchanged.

#### Verified today, on hardware

| | |
|---|---|
| Pairing from the ring's Security Request | **yes** — iOS dialog, bond persists across reflash |
| `#REQ` poke → app answers | **yes** |
| `!TIME`, reading written, `!GET STATUS` | **yes** |
| Ring accepts and confirms the reading | **yes** — `Relaying 128 Flat` |
| Nightscout fetch on the iPhone 18 Pro | **yes** — accurate readings |
| All six buzz patterns, felt and distinguished | **yes** (§14) |

#### Still untested

- **Background operation.** Everything above was with the app in the
  foreground. `#REQ` waking a *suspended* app, and state restoration after a
  system kill, are still assumptions 3.2–3.4.
- **The alarms in real operation.** MISS after a force-quit, STALE from a
  Nightscout outage, and a threshold crossing have not been provoked.
- **Battery.** No cell attached; checklist steps 7–12 untouched. The ring runs
  on USB.
- The free signing expires **2026-09-30**; after that the app stops launching
  and the ring will buzz MISS.

---

### 16. Battery attached, background relay verified (2026-09-24)

#### Cell

A **100 mAh protected LiPo** (AKZYTUE 401230, 3.7 V, JST PH2.0 cut off and
soldered to the `BAT` pads, 32 × 12 × 4 mm) replaced the 40 mAh cell that was
originally planned. The 40 mAh part was out of spec in **both** directions
against this board:

- **Charging:** the XIAO's charge current is fixed at 50 mA in hardware. Into
  40 mAh that is 1.25C, above the 0.5C maximum these cells specify. Into
  100 mAh it is 0.5C — in spec, no external charger, no supervision.
- **Discharging:** a buzz pulls ~85–100 mA from the cell (the motor is on the
  3V3 rail, so the current passes through the regulator). That is ~2.1C on a
  40 mAh cell, past the usual 1C limit, and ~0.85C on the 100 mAh — inside it.

The discharge side was not in the original analysis and only surfaced when the
listing's "non-power battery" note prompted the check.

#### Checklist step 6 — the HARD GATE — passed in both directions

`~CHG` polarity was an assumption (REPORT.md A3) and is now measured:

| | Reading | Meaning |
|---|---|---|
| USB attached | `chg=1` | the guard sees the charger |
| USB out, on cell | `chg=0` | the guard releases, and the ring samples |

Both halves confirmed, so the divider is never sampled while the charger
drives the BAT node — the P0.31 hazard the gate exists to prevent. Step 9 is
covered by the same reading.

#### A battery readout in the app

The second half could not be read at all before: the serial log needs USB, and
USB is the charger, so the firmware (correctly) skips sampling whenever it
could have been observed over the cable. `!GET BATT` over BLE is the only path
— and its `#BATT` reply is only readable because of the truncation fix in §15.

So the app gained a **"Read ring battery"** button showing
`3.838 V (3838 mV) - 57% - on battery`. Raw mV is kept alongside the volts
because that is what `VBAT_DIVIDER_COMP` calibrates against.
`Relay.batteryText` is pure and tested; Swift core tests **141/0**.

#### Calibration: deliberately not done

Checklist step 8 compares the ring's reported mV against a meter. The wearer's
multimeter cannot resolve millivolts, so the comparison was not possible, and
**the wearer chose to proceed on the nominal `1510/510` constant.**

- The ring reported **3838 mV**, a plausible resting voltage for a part-charged
  LiPo, and the meter agreed to its own resolution.
- **The cutoff is therefore uncalibrated.** If the divider over-reports, the
  3300 mV floor fires late; if it under-reports, the ring shuts down with
  charge left.
- **The mitigation is the cell's own protection board**, which backstops
  over-discharge at roughly 2.5–3.0 V regardless of what the firmware thinks.
- **A better calibration exists without a precise meter:** charge to full,
  unplug, let it settle, and read. The BQ25100 terminates at a regulated
  4.2 V, so a reading outside 4.15–4.20 V is divider error and gives the exact
  ratio to scale by. Worth doing at the next full charge.

#### Background relay — assumption 3.2 resolved

With the app **backgrounded and the phone locked**, the relay kept running:
the ring's `#REQ` woke the suspended app, which fetched and wrote back, for
20 minutes with no MISS alarm. Three missed pokes would have buzzed inside
that window, so this test cannot pass falsely.

That is the premise of the whole design — iOS does not allow a timer-driven
background poll, and the ring-driven `#REQ` is the workaround. It works.

#### Still untested going into real use

- **Force-quit → MISS** (acceptance test 4): not confirmed.
- **State restoration after a system kill** (assumption 3.3).
- **STALE from a Nightscout outage**, and a **real threshold crossing** —
  no alert has fired from live data, only from TEST_MODE.
- **Idle current** (checklist steps 11–12): no µA meter. Every battery-life
  figure remains calculated, not measured (assumption 3.14).
- **The signing expires 2026-09-30.** The app then stops launching and the
  ring buzzes MISS until it is reinstalled.
