Alm1973/glucose-ring/hardware/ring-flex-v1/BOM.csv

ref | qty | part | package | value | function | notes
U1 | 1 | Raytac MDBT50Q-1MV2 | module 15.5x10.5x2.05mm |  | nRF52840 + chip antenna | castellated, hand-solderable, pre-certified. 61 pads 0.6x0.4mm. Footprint adopted from github.com/famichu/kicad_libs_MDBT50 and checked against the approval sheet; CONFIRM PIN 1 ORIENTATION before fab.
U2 | 1 | MCP73831T-2ACI/OT | SOT-23-5 | 4.2V | Li-ion charger | charge current set by R3; floor is 15 mA
U3 | 1 | TPS7A0230PDBVR | SOT-23-5 | 3.0V 200mA | motor rail LDO | 25nA Iq. EN has an INTERNAL PULLDOWN so the rail is off at power-on until firmware drives it - same fail-safe as R1 on the motor gate. Dropout 270mV max at 200mA, so 3.0V holds well below the 3300mV cutoff. Confirm the orderable P-suffix part on TI.
U4 | 1 | DW01A | SOT-23-6 |  | cell protection controller | over-charge / over-discharge / over-current
Q1 | 1 | FS8205A | SOT-23-6 | 20V 6A | protection switch | dual N-FET, COMMON DRAIN (D1/D2 shared). S1 to cell negative, S2 to pack negative.
Q2 | 1 | AO3400A or DMG2302U | SOT-23 |  | motor low-side switch | logic level, Vgs(th) < 1.5 V, >=200 mA
M1 | 1 | NFP-C1020 (NFP-FLAT-C1020L) | 10.0x2.0mm coin | 3.0V 80mA max | haptic actuator | flying leads. Vendor quotes BOTH 0.80G and 1.10G on the same page - treat as unreliable and compare against the current 10x3.4mm by hand. 11000rpm = ~183Hz, same as the current motor, so no frequency gain. 2.0mm EXCLUDES the adhesive foam.
D1 | 1 | BAT54W | SOD-323 |  | motor flyback | cathode to V_MOTOR
D2 | 1 | BAT54W | SOD-323 |  | reverse-polarity guard | on the charge contact
R1 | 1 | resistor | 0402 | 10k | gate pulldown | MANDATORY - floating gate runs the motor
R2 | 1 | resistor | 0402 | 1k | gate series | optional - tames the gate edge
R3 | 1 | resistor 1% | 0402 | 66.5k | charger PROG | I = 1000/R(kohm). 66.5k -> 15mA typ, but the datasheet band at 67k is 12.5/15/16.5mA, so worst case 16.5mA = 0.55C on a 30mAh cell. Above 67k enters the shutdown zone.
R4 | 1 | resistor | 0402 | 1k | DW01A supply (R1) | datasheet requires >=470R; 330R was below the minimum
R5 | 1 | resistor | 0402 | 2k | DW01A current sense (R2) | CS to pack negative. Datasheet: R1 and R2 cannot be omitted. Range 1-3k.
C1 | 1 | ceramic X5R | 1206 | 100uF | motor rail bulk | carries the ~85 mA buzz; ceramic is thinner than tantalum
C2 | 1 | ceramic X5R | 0805 | 10uF | VBAT bulk
C3 | 1 | ceramic | 0603 | 4.7uF | charger output
C4 | 1 | ceramic | 0402 | 1uF | charger input
C5 | 1 | ceramic | 0402 | 0.1uF | DW01A
C6 | 1 | ceramic | 0402 | 1uF | LDO output
BT1 | 1 | LiPo cell ~30mAh | 16x8x2.5mm | 3.7V | battery | bare cell - protection is on-board. Now the thickest part at 2.5mm; sets band thickness. Needs UN38.3 paperwork.
J1 | 1 | gold pad 2x2mm | ring-flex-v1:ChargePad_2x2mm |  | charge contact + | ENIG, no paste - a contact surface, not a solder joint
J2 | 1 | gold pad 2x2mm | ring-flex-v1:ChargePad_2x2mm |  | charge contact - | ENIG, no paste
J3 | 0 | USB-C receptacle 16P | Connector_USB:USB_C_Receptacle_HCTL_HC-TYPE-C-16P-01A |  | USB-C charge (DO NOT POPULATE) | pads only. Insurance if BLE DFU misbehaves. ~3.2mm tall - would become the thickest part if ever fitted.
R6 | 1 | resistor | 0402 | 5.1k | USB-C CC1 pulldown | required or a USB-C source supplies no power
R7 | 1 | resistor | 0402 | 5.1k | USB-C CC2 pulldown | required
TP1 | 1 | test pad |  |  | SWDIO
TP2 | 1 | test pad |  |  | SWCLK
TP3 | 1 | test pad |  |  | VBAT
TP4 | 1 | test pad |  |  | GND
C7 | 1 | ceramic | 0402 | 1uF | MCU VDD decoupling | REG0 output on pin 28 - decoupling only, not a supply input
