Alm1973/glucose-ring/hardware/ring-flex-v1/kicad/ring-flex-v1.kicad_sch

## KiCad design hardware/ring-flex-v1/kicad/ring-flex-v1.kicad_sch (2026-10-08, an earlier design)

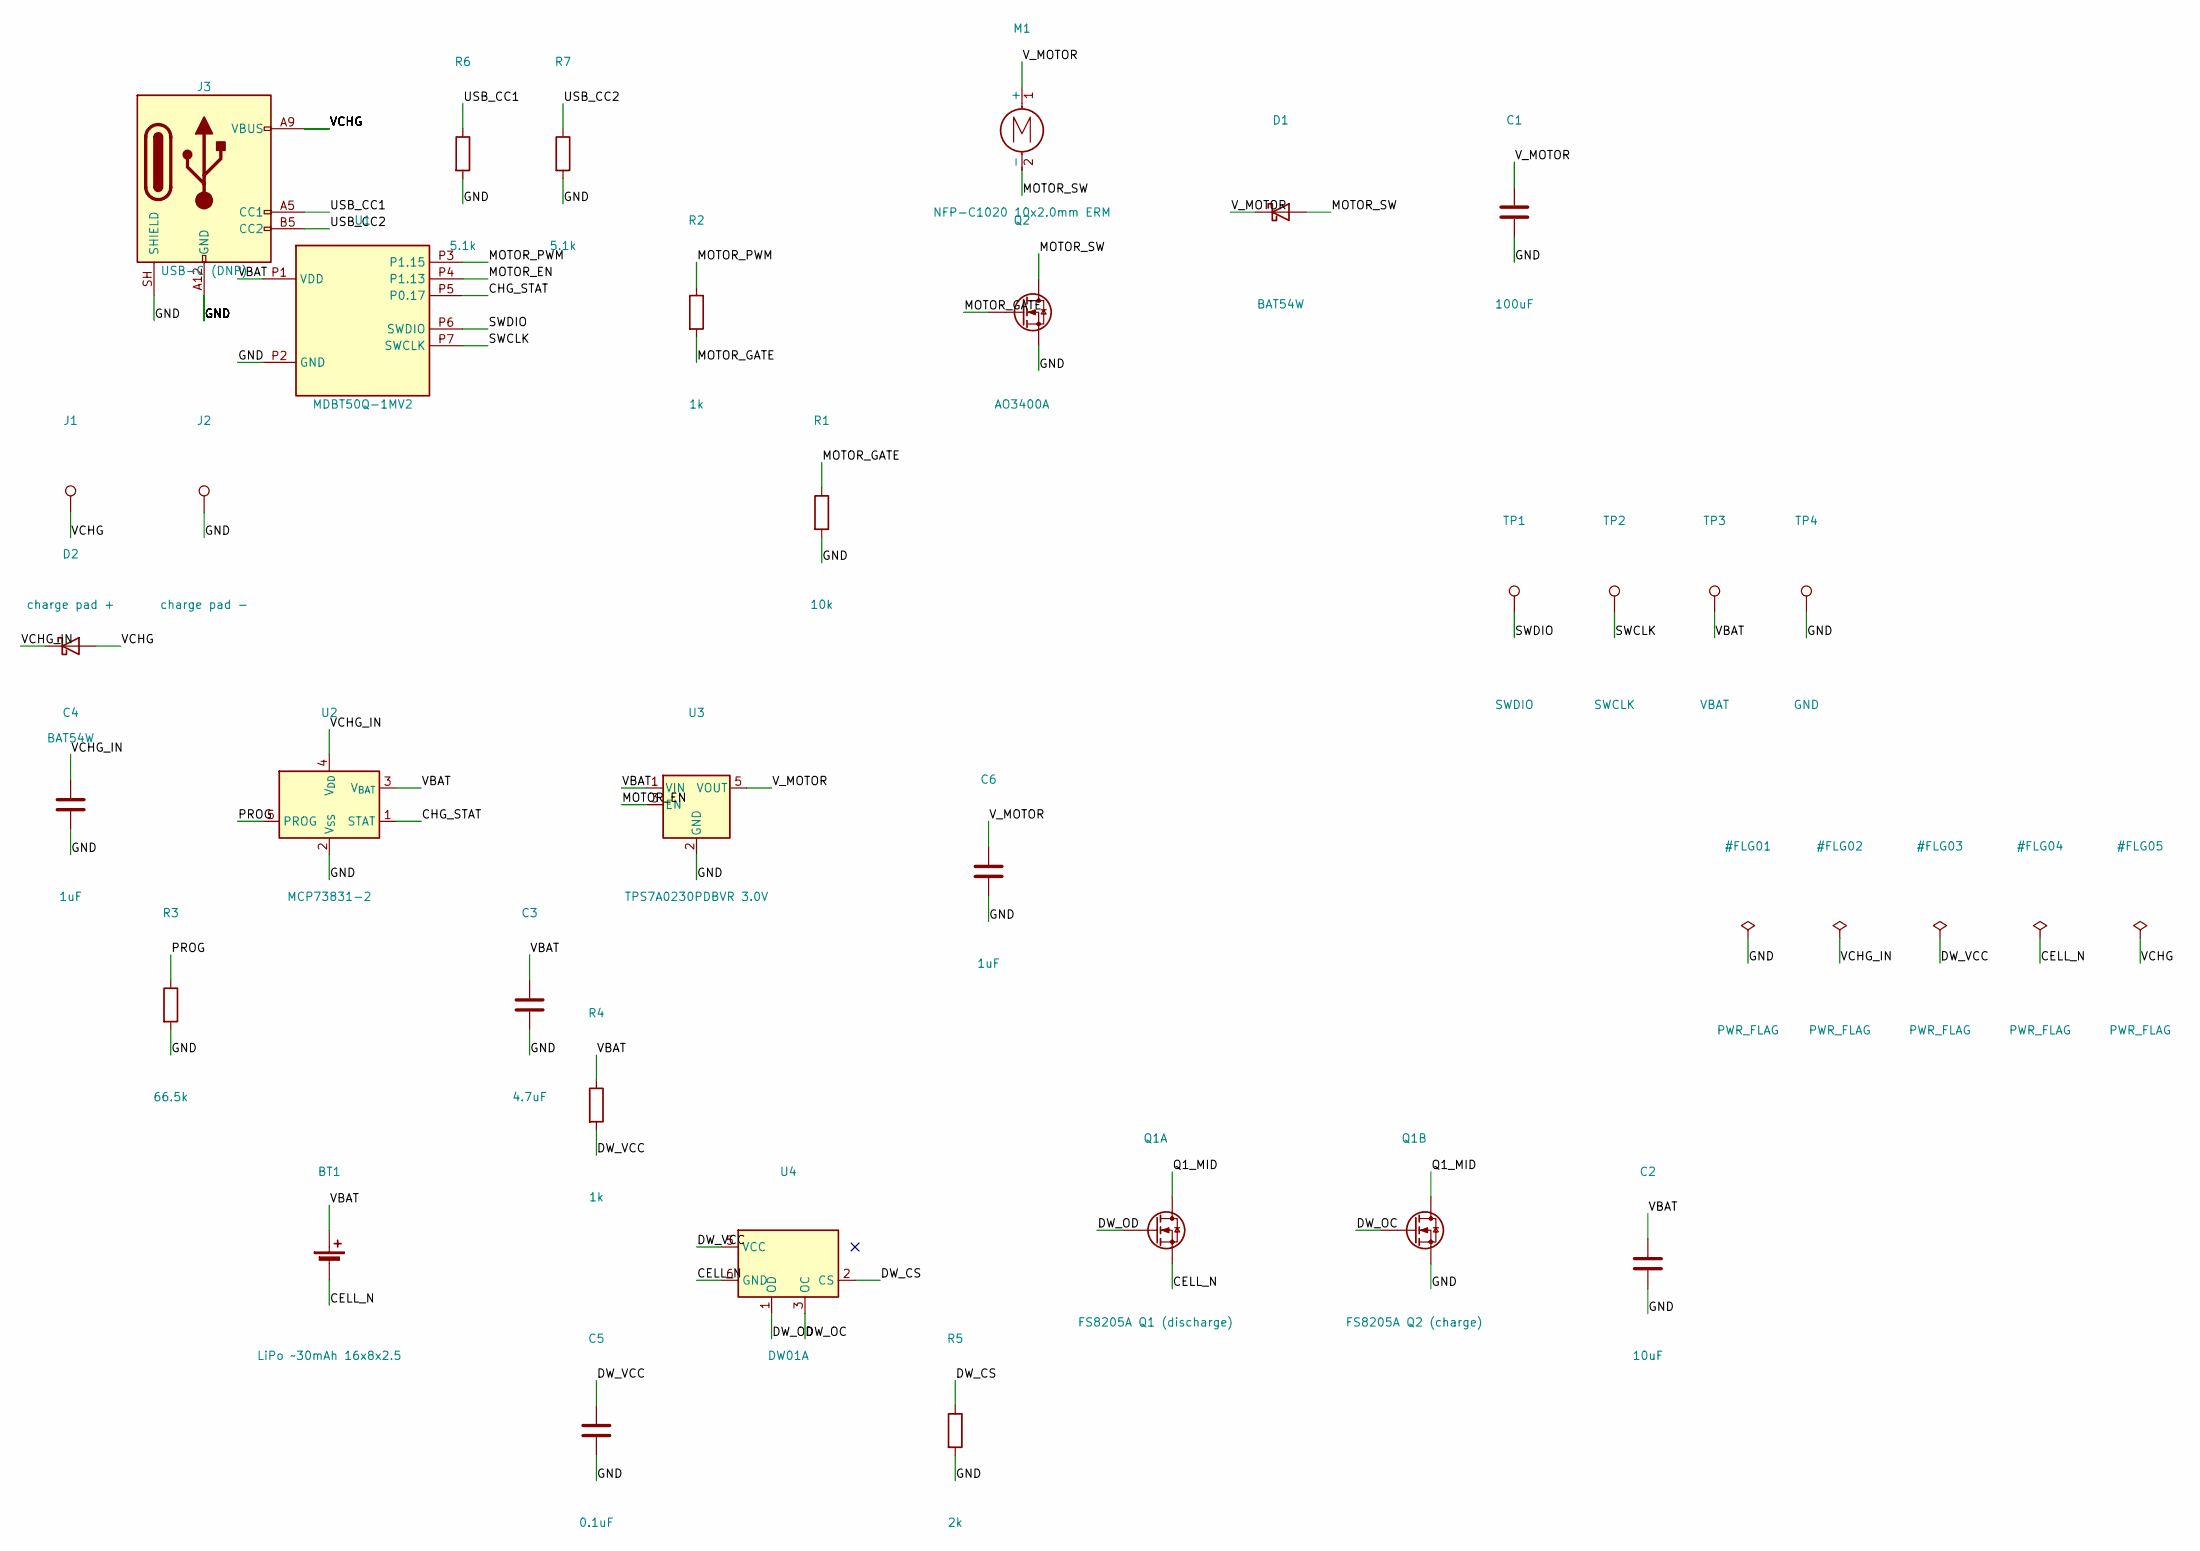
[picture p1: schematic ring-flex-v1.kicad_sch]

Parts:
BT1: LiPo ~30mAh 16x8x2.5; Battery_LiPo_16x8_WirePads
C1: 100uF; C_1206_3216Metric
C2: 10uF; C_0805_2012Metric
C3: 4.7uF; C_0603_1608Metric
C4, C6: 1uF; C_0402_1005Metric
C5: 0.1uF; C_0402_1005Metric
D1, D2: BAT54W; D_SOD-323
J1: charge pad +; ChargePad_2x2mm
J2: charge pad -; ChargePad_2x2mm
J3: USB-C (DNP); USB_C_Receptacle_HCTL_HC-TYPE-C-16P-01A
M1: NFP-C1020 10x2.0mm ERM; Motor_Coin_10mm_WirePads
Q1A: FS8205A Q1 (discharge); SOT-23-6
Q1B: FS8205A Q2 (charge); SOT-23-6
Q2: AO3400A; SOT-23
R1: 10k; R_0402_1005Metric
R2, R4: 1k; R_0402_1005Metric
R3: 66.5k; R_0402_1005Metric
R5: 2k; R_0402_1005Metric
R6, R7: 5.1k; R_0402_1005Metric
TP1: SWDIO; TestPoint_Pad_D1.0mm
TP2: SWCLK; TestPoint_Pad_D1.0mm
TP3: VBAT; TestPoint_Pad_D1.0mm
TP4: GND; TestPoint_Pad_D1.0mm
U1: MDBT50Q-1MV2
U2: MCP73831-2; SOT-23-5
U3: TPS7A0230PDBVR 3.0V; SOT-23-5
U4: DW01A; SOT-23-6

Connections:
CELL_N: BT1.2 (-), Q1A.S, U4.6 (GND)
CHG_STAT: U1.P5 (P0.17), U2.1 (STAT)
DW_CS: R5.1, U4.2 (CS)
DW_OC: Q1B.G, U4.3 (OC)
DW_OD: Q1A.G, U4.1 (OD)
DW_VCC: C5.1, R4.2, U4.5 (VCC)
GND: C1.2, C2.2, C3.2, C4.2, C5.2, C6.2, J2.1, J3.A1 (GND), J3.A12 (GND), J3.B1 (GND), J3.B12 (GND), J3.SH (SHIELD), Q1B.S, Q2.S, R1.2, R3.2, R5.2, R6.2, R7.2, TP4.1, U1.P2 (GND), U2.2 (V_{SS}), U3.2 (GND)
MOTOR_EN: U1.P4 (P1.13), U3.3 (EN)
MOTOR_GATE: Q2.G, R1.1, R2.2
MOTOR_PWM: R2.1, U1.P3 (P1.15)
MOTOR_SW: D1.2 (A), M1.2 (-), Q2.D
PROG: R3.1, U2.5 (PROG)
Q1_MID: Q1A.D, Q1B.D
SWCLK: TP2.1, U1.P7 (SWCLK)
SWDIO: TP1.1, U1.P6 (SWDIO)
USB_CC1: J3.A5 (CC1), R6.1
USB_CC2: J3.B5 (CC2), R7.1
VBAT: BT1.1 (+), C2.1, C3.1, R4.1, TP3.1, U1.P1 (VDD), U2.3 (V_{BAT}), U3.1 (VIN)
VCHG: D2.2 (A), J1.1, J3.A4 (VBUS), J3.A9 (VBUS), J3.B4 (VBUS), J3.B9 (VBUS)
VCHG_IN: C4.1, D2.1 (K), U2.4 (V_{DD})
V_MOTOR: C1.1, C6.1, D1.1 (K), M1.1 (+), U3.5 (VOUT)
