Alm1973/glucose-ring/(commit log)

2026-09-10 Initial commit: glucose-ring v2 firmware for XIAO nRF52840
    Haptic CGM alert ring. BLE peripheral exposing Nordic UART Service as
    "GlucoseRing"; a phone pushes readings, the ring buzzes on high/low/stale.
    Firmware:
    - Motor gate on D10 (P1.15), same board edge as GND/3V3. Drives an external
    AO3400; the ~85 mA motor current never touches the nRF52.
    - Thresholds are RC_UNSET placeholders. An unset side never alerts, and every
    build warns until set. Choosing clinical values is not the firmware's job.
    - Battery: divider pulsed and released to high-Z, never sampled while the
    charger is active (~CHG P0.17 plus USB VBUS), shutdown suppressed on charge,
    permanent SYSTEM OFF below a confirmed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
    [command.cpp, command.h, glucose-ring.ino, reading_parser.cpp, reading_parser.h, ring_config.cpp, ring_config.h]
2026-09-10 Cap stale alerting, buzz on watchdog reset, harden bring-up gates
    Stale repeat cap (schema 2, new stale_max_repeats, default 6):
    after N consecutive stale buzzes the ring emits a distinct terminal pattern,
    sends #ALERT stale_giveup, and goes quiet until fresh data arrives. A ring
    buzzing every few minutes in a drawer for hours trains the wearer to ignore
    it, and an ignored alert is a worse hazard than the silence the repeats were
    guarding against. The giving-up signal is distinct so the silence afterwards
    reads as "it stopped trying", not "it got fixed". !SET STALEREPEATS 0 restores
    unlimited repeating. A v1 config file still loads and picks up the default.
    A watchdog reset now buzzes a dis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
    [command.cpp, glucose-ring.ino, ring_config.cpp, ring_config.h]
2026-09-10 Add Android courier app: xDrip+ broadcast -> BLE NUS -> ring
    Toolchain installed (approved): android-commandlinetools with SDK platform 34
    and build-tools 34.0.0. Homebrew's gradle is 9.7.1 on JDK 26 and no Android
    Gradle Plugin supports either, so the project pins a Gradle 8.11.1 wrapper with
    AGP 8.7.3 and points org.gradle.java.home at the JDK 21 already installed.
    RingProtocol.kt and Reading.kt are pure Kotlin with no Android imports, so the
    wire format is unit-testable on the JVM. Their 22 tests use the vectors from
    PROTOCOL.md section 8 -- the same table the firmware's host tests assert, so
    both ends of the link are checked against one specification.
    Two traps the firmware's strictnes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
2026-09-12 Replace xDrip+ input with a Nightscout relay
    The phone app now polls Nightscout every 60 s (read-only token, ?token=)
    and relays each new reading to the ring over NUS. It never sends a reading
    older than 15 min, future-dated, or outside 20-600, and never fabricates
    one. The ring cannot catch a stale first reading after a reboot on its
    own, so this check is the only guard for that case.
    The notification says "Relaying" only when a fresh reading was written and
    the ring's own !GET STATUS confirms it; every other state reads
    "NOT relaying: <reason>" in plain words (Nightscout unreachable, token
    rejected, data too old, ring not connected, permission refused, ...).
    NusClient now bonds before di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
2026-09-12 Add host-side cross-check: app wire bytes through firmware rp_parse()
    tests/run_wire_crosscheck.sh has the app's own formatter (WireExportTest)
    write every sgv 20-600 x 16 directions x 3 timestamps, builds
    tests/wire_crosscheck.cpp against reading_parser.cpp with run_tests.sh's
    flags (incl. UBSan), and feeds the 27,888 lines in 20-byte chunks through a
    copy of pumpUart()'s framing. Any line that does not decode exactly fails
    the run.
    A formatter/parser disagreement would otherwise look exactly like a dead
    link: the ring drops a malformed reading silently and never buzzes.
    Verified in both directions: the clean run passes 27,888/27,888, and an
    extra field, a wrong expected value, and a miss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
2026-09-12 Retire the Android relay app; describe the iOS design
    The phone is an iPhone, so the Kotlin app cannot be used. It is removed
    with git rm and nothing is lost:
    branch nightscout-relay (now also merged into main), app commit c306487
    restore: git restore --source=nightscout-relay -- android/
    Ignored files under android/ (local.properties, build outputs) were left
    on disk on purpose; .gitignore still covers them.
    PHONE_APP.md now describes the iOS design. The ring drives the cycle with a
    #REQ notify; the app answers with !TIME, then the reading; the ring's miss
    counter alarms when the phone stops answering. Requirements carried over
    from the Android design are unchanged.
    tests/run_wire_c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
2026-09-12 Firmware: the ring drives the cycle (protocol 3)
    iOS will not let the phone poll on a timer in the background, but it wakes
    a bluetooth-central app when a connected peripheral notifies. So the ring
    now sends #REQ on the existing NUS TX characteristic every ~5 min, with no
    new UUID. The phone answers !TIME <epoch_ms>, then the reading.
    - Miss counting: a poke not answered by !TIME within 30 s, or one that
    falls due with no usable link, is a miss. After LV_MISS_ALERT_COUNT (3)
    in a row, about 15 min blind, the ring buzzes MISS: a fixed 2 x 1000 ms
    full-drive pattern that is refused as a low/high/stale pattern. Only a
    current low/high outranks it, so a blind ring is never silent.
    - Tru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
    [command.cpp, command.h, glucose-ring.ino, liveness.cpp, liveness.h, ring_config.cpp, ring_config.h]
2026-09-12 iOS relay app: answers the ring's #REQ, relays Nightscout
    The ring pokes (#REQ); iOS wakes the app through the bluetooth-central
    background mode; the app writes !TIME at once, does one Nightscout GET, and
    writes the reading back, then confirms it with !GET STATUS.
    - ios/Core (pure Swift): wire format, strict Nightscout parsing (whole
    numbers only, ms epoch, no coercion), relay rules (only current readings,
    dedupe per link, a sticky "token rejected" that a network blip cannot
    clear, honest status), backoff.
    - ios/GlucoseRing: CBCentralManager with a restore identifier;
    willRestoreState reattaches rather than rescanning; the central is created
    in didFinishLaunching. Immediate non-ex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
2026-09-13 iOS app runs on the iPhone; record signing team and expiry
    The app was installed from Xcode onto the iPhone 11 (iOS 26.6.2); devicectl
    confirms Glucose Ring 0.1.0 (1). On first launch it shows the expected
    no-ring state ("Waiting for the ring", "No ring chosen yet"), which also
    shows that CoreBluetooth is powered on and authorised.
    Xcode set DEVELOPMENT_TEAM (Personal Team) in both target configurations.
    The free provisioning profile expires on 2026-09-20 at 04:26 UTC; the app
    must be reinstalled before then.
    Everything that needs the ring is still untested: pairing, #REQ wakes, the
    app's Nightscout fetch, and the writes.
2026-09-13 iOS app: add an app icon; show the name "GRing"
    The icon is a brushed-silver ring with a red glucose drop, on a
    navy-to-teal background. It is drawn by ios/tools/make_app_icon.swift (Core
    Graphics) as an opaque 1024x1024 PNG in Assets.xcassets/AppIcon, and is
    wired in with ASSETCATALOG_COMPILER_APPICON_NAME in both configurations.
    The home-screen name, the Bluetooth permission text and the "token
    rejected" notification now say "GRing". The target, project and bundle ID
    (com.glucosering.relay) are unchanged, and so is the ring's Bluetooth name
    GlucoseRing, which the firmware advertises.
    Unsigned iphoneos build: 0 errors, 0 warnings; the icon and the name are
    present in the built app.
    Co-Au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
2026-09-13 iOS app: Test Nightscout button
    A button runs the app's real, read-only Nightscout fetch on demand and shows
    the result in plain words: the latest reading and its age, "Token rejected",
    "Can't reach Nightscout", and so on. It proves the token, network and parsing
    on the phone before a ring exists. Nothing is written to the ring, and a test
    never counts as a ring request.
    A 401/403 from a test is recorded as a rejected token, as permanent as ever;
    nothing else in the relay state changes. In particular a test never uses up a
    reading the ring should still receive.
    The per-fetch wording moves into Relay.dataProblem, shared by the status
    screen and the button, so the two can never describe the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
2026-09-13 Firmware: set thresholds to low 60, high 160 mg/dL
    These are the wearer's choice (2026-09-12), set as the compile-time defaults
    that seed the config on first boot. The comparisons are strict: LOW below 60,
    HIGH above 160. !SET THRESH changes them later without reflashing.
    static_asserts now refuse out-of-range or inverted defaults. A typo would
    otherwise be saved to flash on first boot, with nothing validating that
    write. Proven by a negative build: low 200 fails with "must be below
    DEFAULT_HIGH_MG_DL".
    The firmware builds with 0 warnings (the placeholder-threshold #warning is
    gone) in the default and TEST_MODE/DEBUG_SERIAL builds; host tests 450/0.
    README section 1 and IOS_APP_REPORT.md s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
    [glucose-ring.ino]
2026-09-13 Docs: Nightscout fetch verified on the iPhone
    The Test Nightscout button reported "Nightscout works" on the iPhone 11
    (iOS 26.6.2). The app's own HTTPS fetch reaches the live server, the bundled
    token is accepted, and the live entry parses as a current, usable reading.
    Before this, the path had been verified only with curl on the Mac.
    Everything that needs the ring is still untested.
2026-09-24 Docs: ring bring-up on hardware, iPhone 18 Pro install, motor on 3V3
    The ring hardware arrived, was assembled and powered for the first time.
    Firmware: fw 3.0.0 / proto 3 flashed to the XIAO nRF52840 over serial DFU.
    Bring-up build (TEST_MODE, DEBUG_SERIAL, no watchdog): flash 138,988 B (17%),
    RAM 14,660 B (6%). Production defaults: flash 137,292 B (16%), same RAM.
    Zero warnings in both; the placeholder-threshold #warning no longer fires
    because the thresholds are set.
    TEST_MODE: all six buzz patterns ran and were felt as distinct on a finger,
    which resolves assumption 3.13 -- MISS (2 x 1000 ms) versus low (3 x 400 ms).
    That was the design's only untested ergonomic claim. Charge detect rea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
2026-09-24 Firmware: chunk ring->phone lines to the MTU
    Every reply the ring sent was silently truncated at 23 bytes.
    BLECharacteristic::notify() opens with `remaining = min16(len, _max_len)`,
    and BLEUart::begin() sets _max_len to the peripheral's max MTU -- 23 here,
    because we ask for BANDWIDTH_LOW. Anything beyond that is dropped and the
    call still reports success, so nothing upstream could detect it. sendLine()
    wrote each whole line in a single call, so
    "#STATUS sgv=142 dir=Flat age_s=1 stale=0 alert=none up_s=..."
    reached the phone as "#STATUS sgv=142 dir=Fla". That parses cleanly, so the
    app saw sgv=142 with no stale field and correctly refused to believe the ring
    had taken the reading -- it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
    [glucose-ring.ino]
2026-09-25 iOS app: read the ring's battery over BLE
    Checklist step 8 needs the ring's reported mV, and there was no way to see it
    once a cell was attached: the serial log needs USB, and USB is the charger,
    so the firmware correctly skips sampling the divider whenever it could have
    been read over the cable. !GET BATT over BLE is the only path, and its #BATT
    reply only survives the link since the MTU chunking fix.
    Adds a "Read ring battery" button showing, for example,
    3.838 V (3838 mV) - 57% - on battery
    Raw mV is kept alongside the volts because that is the number
    VBAT_DIVIDER_COMP is calibrated against. Relay.batteryText is pure and does
    not guess: a missing or zero field reads "?" rather than b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
2026-09-25 Alerts: a tick every minute, the full pattern on news
    While a low or high stands, the ring buzzed the full pattern every five
    minutes and nothing in between. The wearer asked for something more
    insistent: one short buzz a minute, with the full three-pulse pattern kept
    for something genuinely new.
    serviceAlerts now distinguishes the two. The full pattern fires when the
    alert starts, when a fresh reading still crosses the threshold, or on the
    existing repeat_minutes fallback. Otherwise, while a glucose alert stands,
    one BZ_TICK every ALERT_REMIND_MS (60 s). So a standing low reads:
    0:00 three buzzes (new reading, still low)
    1:00 tick
    ...
    5:00 three buzzes (new reading, still low)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
    [glucose-ring.ino]
2026-10-08 Hardware: ring-flex-v1 schematic, ERC clean
    First custom board for the ring: a flexible PCB replacing the hand-wired
    XIAO. Design intent, decisions and constraints are in
    hardware/ring-flex-v1/README.md; the connection list is NETLIST.md and the
    parts are BOM.csv.
    The schematic is generated by kicad/gen_sch.py and verified with kicad-cli:
    0 electrical ERC violations, and the exported netlist matches the intended
    design net for net. The 30 remaining ERC entries are lib_symbol_issues from
    kicad-cli running without a global symbol library table; they do not appear
    in the GUI.
    Design decisions worth stating:
    - Raytac MDBT50Q-1MV2 rather than a bare nRF52840: pre-certified, castellated
    and h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
    [BOM.csv, ring-flex-v1.kicad_sch]
2026-10-08 Hardware: footprints assigned, flex board outline
    Decisions from the wearer: 10 mm band, magnetic charge contacts, closed ring,
    65 mm circumference on the index finger, MCP73831 charger, keep the 1k gate
    resistor, USB pads laid out but unpopulated, no LED, no button, JLCPCB, port
    the bootloader variant.
    Footprints assigned to every part except the three that need real land
    patterns: U1 (MDBT50Q module), M1 (motor) and BT1 (cell). Those stay empty
    rather than invented -- a fabricated land pattern passes every check and
    arrives as a dead board.
    New ring-flex-v1.kicad_pcb carries the 65.0 x 10.0 mm outline on Edge.Cuts
    with the island and bend zones marked on Dwgs.User, the antenna keep-out o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
    [ring-flex-v1.kicad_pcb, ring-flex-v1.kicad_sch]
2026-10-08 Firmware: board variant for ring-flex-v1; module datasheet numbers
    Adds a BOARD selector so the custom flex board can be built from the same
    source without disturbing the ring that is in service. BOARD defaults to
    BOARD_XIAO, and the default build is byte-identical to the previous one
    (137,532 bytes) -- the live firmware is provably unchanged.
    BOARD_RING_FLEX_V1 changes three things:
    - The motor rail's LDO is gated by a GPIO, raised in runPattern() and dropped
    after, so the regulator draws nothing between buzzes. On a 30 mAh cell that
    matters in a way it never did on the XIAO's always-on 3V3.
    - readVbatMv() reads the SAADC's own VDD input rather than an external
    divider: the MCU runs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
    [glucose-ring.ino]
2026-10-08 Hardware: motor and cell footprints; real motor part identified
    Two of the three missing footprints are done. Both are wire-attach pads,
    which is a choice I am making rather than a vendor land pattern I would be
    inventing - these motors and cells ship with flying leads, so there is no
    land pattern to get wrong. Each footprint says so in its description.
    Motor_Coin_10mm_WirePads 10 mm body outline, 2 pads for AWG32 leads
    Battery_LiPo_16x8_WirePads 16 x 8 mm keep-out, 2 pads
    Both render through kicad-cli. U1 remains without a footprint: the module's
    61-pad land pattern has to come from Raytac.
    Motor part identified and corrected. The "10 x 2.1 mm, 1.1 G at 233 Hz"
    figure I quoted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
    [BOM.csv, ring-flex-v1.kicad_sch]
2026-10-08 Hardware: fix the cell protection circuit against the datasheets
    Three errors, all in the part I built from memory rather than from a
    reference. Found by reading the FS8205A and DW01A datasheets.
    1. THE FETS WERE WIRED BACKWARDS. I had the FS8205A's two MOSFETs tied
    source-to-source. The datasheet's own marking diagram is
    G1 D1/D2 G2
    8205A
    S1 D1/D2 S2
    so the part shares its DRAINS. Q1_MID is now the common drain, S1 goes to
    the cell negative and S2 to pack negative. As drawn before, the
    protection would not have worked.
    2. R4 was 330 R. The DW01A datasheet sets a 470 R minimum for R1. Now 1 k.
    3. R5 was missing entirely. CS was tied st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
    [BOM.csv, ring-flex-v1.kicad_sch]
2026-10-08 Hardware: real LDO part, and the charger's tolerance band
    U3 was a placeholder. It is now TPS7A0230PDBVR: 3.0 V fixed, SOT-23-5,
    200 mA, 25 nA quiescent.
    Two properties of that part matter to this design:
    - Its EN pin has an internal pulldown, so the motor rail is off at power-on
    and stays off until firmware drives EN high. That is the same fail-safe
    R1 gives the motor gate, and it means a reset or a spell in the bootloader
    cannot leave the rail live.
    - Dropout is 270 mV max at 200 mA, and the motor draws about 85 mA, so the
    3.0 V rail still regulates well below the 3300 mV cutoff. That answers the
    worry from the POC, where the cutoff sat awkwardly close to the XIAO
    regulator's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
    [BOM.csv, ring-flex-v1.kicad_sch]
2026-10-08 Hardware: charge pads and an unpopulated USB-C
    Charge contacts are now real 2 x 2 mm pads rather than 1 mm test points,
    in a footprint that deliberately omits the paste layer: these are contact
    surfaces for pogo pins, not solder joints. Specify ENIG so they do not
    corrode against a spring contact.
    USB-C added as pads only, DO NOT POPULATE, per the decision to charge
    through the dock and flash over SWD. It is insurance: if BLE DFU fights
    back during bring-up, populating this restores the UF2/serial path the XIAO
    has today. It is a 16P footprint because its pads are a superset of the
    power-only symbol's pins; the data pads simply go unused.
    R6 and R7, 5.1 k on CC1 and CC2, are not optional -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
    [BOM.csv, ring-flex-v1.kicad_sch]
2026-10-08 Hardware: board regenerated from a script, islands rebudgeted
    The board is now produced by kicad/gen_pcb.py rather than being a one-off
    file, so the outline and zones can be regenerated as the design moves.
    The island budget changed because of how the antenna keep-out works. Put the
    module flush against x=0 with its antenna facing the board edge and the
    datasheet's 12.4 x 3.8 mm "no ground pad" area falls off the board -- there
    is no host copper there because there is no board there. The 3.8 mm I had
    written off as lost is free, which is what lets the power section have a
    proper island:
    [A: module 15.5] -3.5- [B: power 12] -3.5- [C: cell 16] -3.5- [D: motor 11]
    54.5 mm of parts and 10.5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
    [ring-flex-v1.kicad_pcb]
2026-10-08 Hardware: module footprint adopted and verified; every part now has one
    U1 was the last component without a footprint. Rather than reconstruct 61
    pad positions from a drawing, I took the public one from
    github.com/famichu/kicad_libs_MDBT50, upgraded it to the current format, and
    checked it against Raytac's approval sheet:
    pad count 61 vs 61
    pad size 0.6 x 0.4 mm vs all 0.6 x 0.4 (36 landscape, 25 rotated)
    numbering 1-61 vs contiguous 1-61
    pad field ~11.7 mm tall vs 10.90 centre-to-centre, ~11.5 outer
    Everything checkable agrees. The 0.2 mm on field height is within how a
    dimension is read off a drawing.
    What I did NOT verify, and canno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
    [BOM.csv, ring-flex-v1.kicad_sch]
2026-10-08 Hardware: real module pins, and the supply moves to VDDH
    Two findings from the approval sheet, one of them a design error.
    PIN NUMBERS ARE REAL NOW. Section 2.5's table gives them: GND on 1, 2, 15,
    33 and 55; P1.13 = 6; P1.15 = 8; P0.17 = 41; VDD = 28; VDDH = 30;
    SWDIO = 51; SWDCLK = 53. The P1-P7 placeholders are gone, and with them the
    largest remaining unknown in the schematic.
    THE SUPPLY WAS ON THE WRONG PIN. I had the cell feeding VDD. Section 8 of
    the datasheet says to supply VDDH when the input can reach 3.6 V or more,
    and a full LiPo is 4.2 V against a 3.6 V maximum on VDD. The cell now feeds
    pin 30 (VDDH); pin 28 (VDD) is REG0's output and gets C7, a decoupling cap,
    nothing else.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
    [BOM.csv, ring-flex-v1.kicad_sch]
2026-10-08 Hardware: FS8205A is one part, drawn as one symbol
    The schematic had the protection FETs as two Q_NMOS symbols, Q1A and Q1B.
    They are one physical device, so the board would have carried two SOT-23-6
    footprints for a single FS8205A. Caught by cross-checking the BOM against
    the netlist -- the BOM said Q1, the netlist said Q1A and Q1B.
    Replaced with a proper 6-pin FS8205A symbol in the project library. The
    pinout is read off the datasheet's marking diagram, where the pin-1 dot sits
    beside S1:
    1 = S1 2 = D1/D2 3 = S2 4 = G2 5 = D1/D2 6 = G1
    Wired as: S1 to the cell negative, S2 to pack negative, G1 to the DW01A's
    discharge control and G2 to its charge control, with pins 2 and 5 f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
    [ring-flex-v1.kicad_sch]
